jacrify/pumpcontrol/README.md

Python scripts to control a poolpump.

See details [here](https://jacrify.github.io/pumpcontrol/)
