jacrify/pumpcontrol/docs/arduino.md

To get my PC to control my pool pump, I had a couple of problems:
My pool pump is 20m from my house.
I don't enjoy electrocution

I looked at off the shelf arduino solutions for controlling mains power, but ended up buying a set of Watts Clever remote control power points.

Watts Clever

Watts Clever

Watts Clever

Watts Clever

Watts Clever

Watts Clever
