jacrify/pumpcontrol/(list of files, drawings)

Other design files:
docs/assets/pumpControl.fzz
